ChrisColbourne/Hackathon26-/website/assets/photos/circuit-diagram.jpg

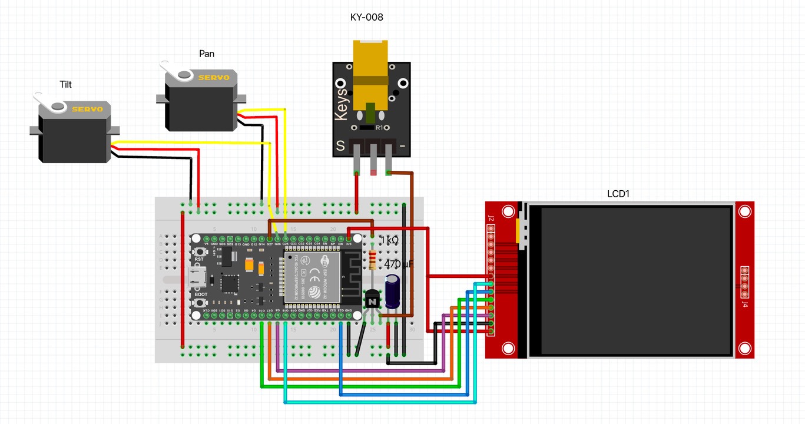
website/assets/photos/circuit-diagram.jpg
