ChrisColbourne/Hackathon26-/app/otter-website/incoming/robot_model.stl

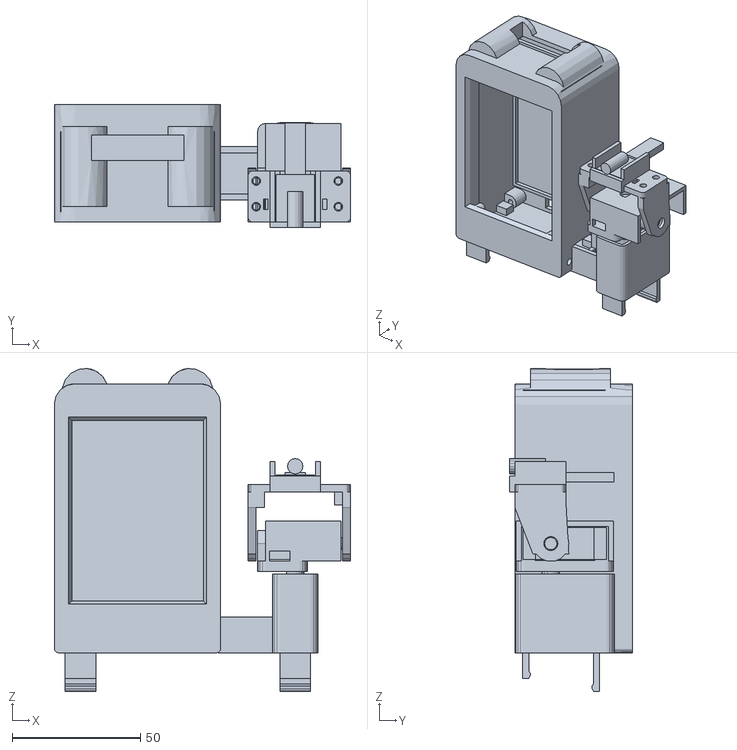
[picture p4: CAD file, 2026-10-04, last stored version]
app/otter-website/incoming/robot_model.stl
115.4 x 47.7 x 125.8
