ChrisColbourne/Hackathon26-/website/assets/photos/build-first-boot.jpg

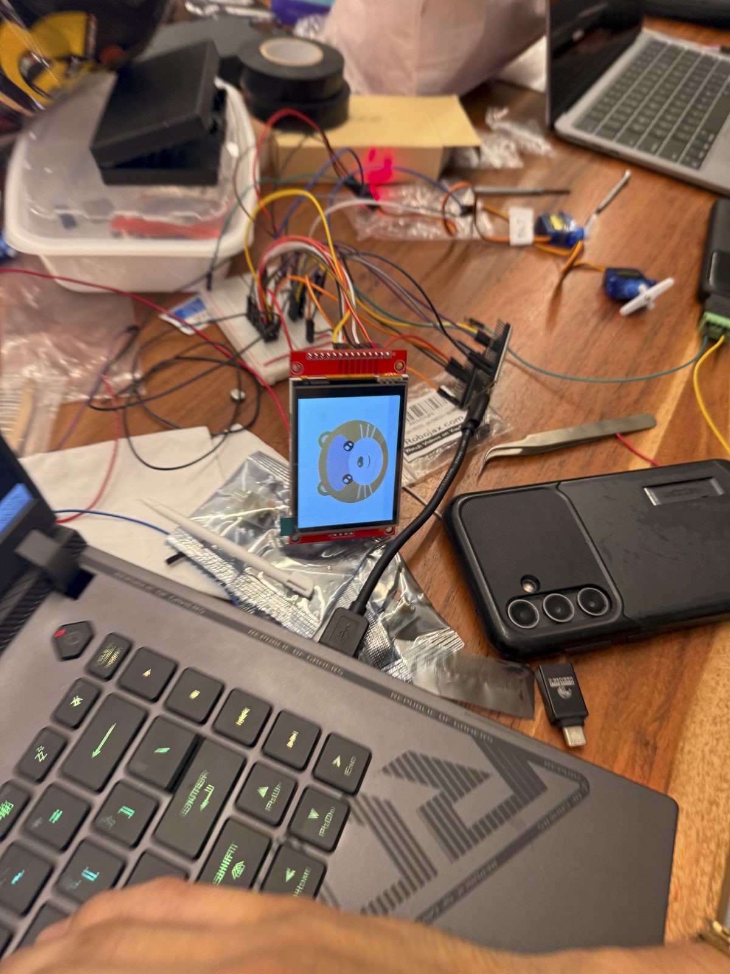
website/assets/photos/build-first-boot.jpg
