ChrisColbourne/Hackathon26-/website/assets/photos/build-printed-case.jpg

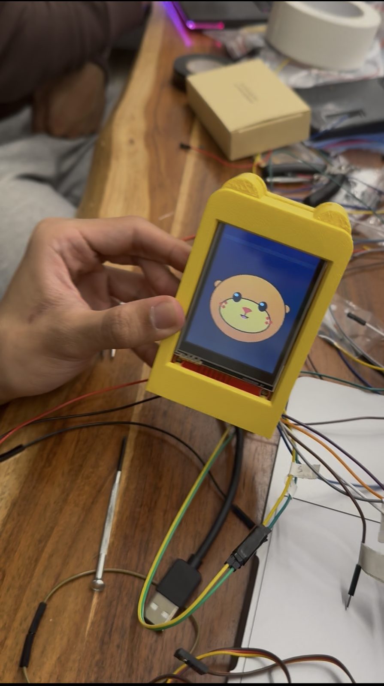
website/assets/photos/build-printed-case.jpg
