ChrisColbourne/Hackathon26-/website/assets/photos/final-back-wiring.jpg

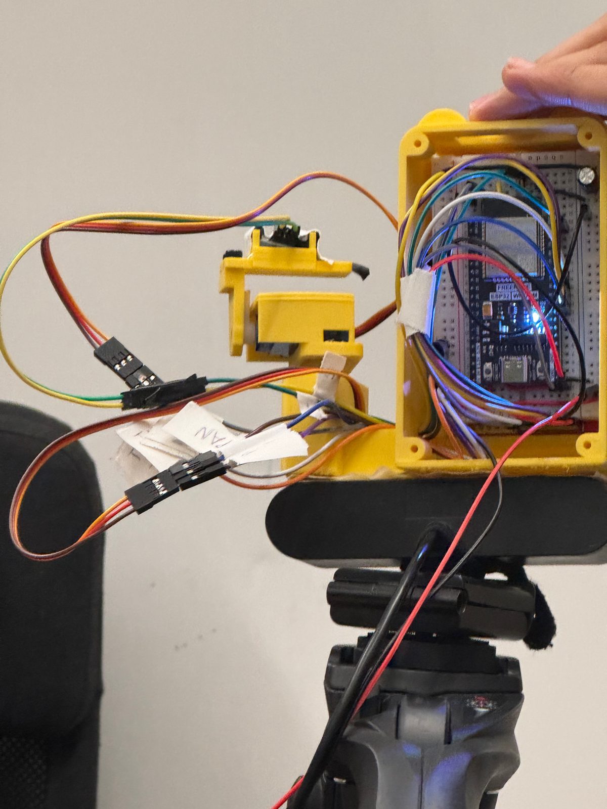
website/assets/photos/final-back-wiring.jpg
