ChrisColbourne/Hackathon26-/website/assets/photos/final-test-tripod.jpg

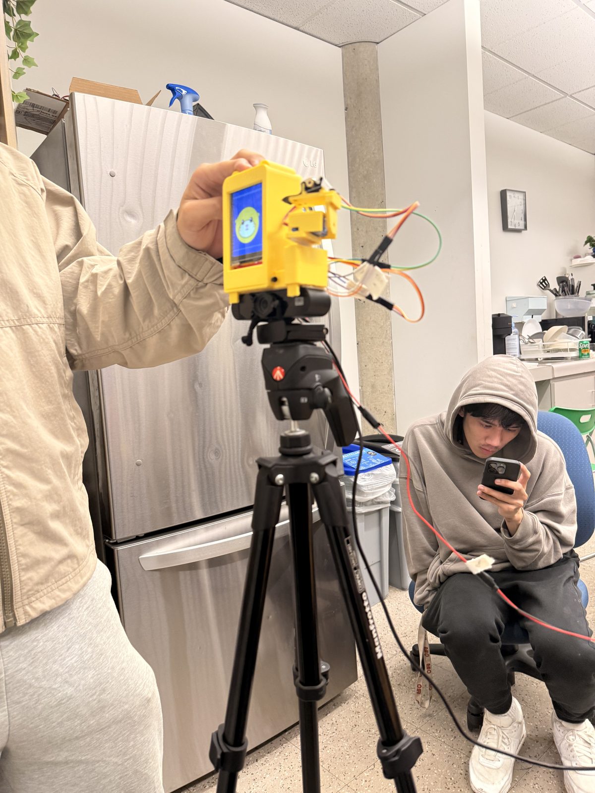
website/assets/photos/final-test-tripod.jpg
