ChrisColbourne/Hackathon26-/(commit log)

2026-10-04 Add the Gemini brain: webcam -> verdict -> nudge, robot and app server
    Laptop brain for the otter tutor (Person B). Reads the whiteboard through
    the USB webcam, decides whether each line is right, and has the otter
    flag mistakes out loud without ever giving away the fix.
    - gemini_brain: Interactions API with structured JSON (BoardAnalysis).
    Adaptive model chain (3.8 -> 3.7 -> 3.6-flash) that demotes models
    after 503s/timeouts/429s, API-key rotation, hard per-call deadline, and
    SDK retries disabled (they slept for the full 429 Retry-After).
    - verifier: SymPy re-derives derivatives/integrals/algebra and vetoes
    false flags on correct work.
    - policy: speak only above a confidence thresh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
2026-10-04 Add ESP32 otter firmware (PlatformIO + Arduino IDE versions)
    LeandroZambrano21's LCD/servo/laser firmware, uploaded via the GitHub web
    UI to both main and lcd_screen. Consolidated here on lcd_screen for review:
    - otter-robot-esp32/: PlatformIO project (as uploaded to lcd_screen)
    - otter-robot-arduino/: Arduino IDE sketch (as uploaded to main); its
    otter.cpp and net.cpp are edited versions of the PlatformIO ones
    Left out: both secrets.h files (they held real Wi-Fi credentials; copy
    secrets.example.h to secrets.h locally) and the *.bak originals.
    .gitignore now covers secrets.h, *.bak and .pio/.
2026-10-04 Brain: fix robot integration bugs found against the ESP32 firmware
    Tested with an emulator of the firmware's main.cpp state machine
    (pending / laserAfterMove, eased 50 Hz servo motion, laser timeout)
    driven by the real server in mock mode.
    - server: also accept the firmware's default path /robot (was 403).
    - server/robot: a reconnect after a Wi-Fi blip no longer gets detached
    when the server later notices the old socket closed. Before, the live
    robot was dropped and the brain silently fell back to mock commands.
    - robot: one ordered show(mood, box) sequence instead of running the
    mood head-tilt and the laser aim concurrently; a late look could
    re-target a pending laser. point_at sen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
2026-10-04 Firmware: connect to the brain on 8000, laser safety on look, one version
    Review fixes for the ESP32 firmware (PR #1), agreed with the team:
    - Keep the Arduino IDE version (newer: has the reconnect fix and the
    team's otter design); remove the stale PlatformIO copy, whose net.cpp
    reset the face, head and laser every 2 s while no server was running.
    - secrets.example.h: SERVER_PORT 8000 to match brain.server (path /robot
    is now accepted by the brain). test_server.py moves to 8000 as well, so
    the firmware needs no change between the brain and the test server.
    - otter_robot.ino: a plain look switches the laser off and cancels a
    pending laser-on. Before, a look arriving after a laser c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
2026-10-04 Brain: live preview, sensitive re-checks, USB bridge, robot test
    From the first full hardware session (camera + ESP32 + Gemini):
    - server --show: camera preview window with c (check now), b (board
    detection), q keys, so one command gives the view and drives the robot.
    Uvicorn runs on a background thread; Qt stays on the main thread.
    - Re-checking: change threshold 0.015 -> 0.0001 (CHANGE_THR). Measured
    on the real board: camera noise 0.00000, erasing one character
    0.00033; the old value missed every handwriting edit.
    - Policy: the flag-once key includes the wrong line's text, so writing
    a different wrong answer on the same line gets a new nudge.
    - Server logs one CHECK line per ch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
2026-10-04 Firmware: fix inverted laser, wireless (OTA) updates, flash.sh
    - LASER_ACTIVE_LOW: this robot's laser lights when GPIO 27 is LOW (wired
    without the transistor), so "off" kept it lit and idle meant always on.
    The pin is now also set before anything else at boot.
    - ArduinoOTA: flash over Wi-Fi with ./flash.sh ota (optional OTA_PASS in
    secrets.h); laser off and face "thinking" while an update runs.
    - flash.sh: build + flash over USB or Wi-Fi with arduino-cli.
    Verified on hardware with brain.tools.robot_test: face, laser off/on/off,
    pan left/right, tilt up/down all correct.
2026-10-04 Brain: auto-check every 5 s, always answer an on-demand check
    - MIN_CHECK_INTERVAL_S 12 -> 5 so edits are re-checked ~5 s apart
    (still waits for the board to hold still STILL_S first).
    - Pressing "c" now always gets a spoken reply. Auto checks stay quiet
    when there's nothing new; on demand the otter confirms correct work,
    repeats an earlier nudge (and re-aims the laser), or says why it
    can't judge yet (half-written line, unreadable, no problem on board).
2026-10-04 Firmware: portrait otter face for the vertically mounted LCD
    - Screen now 240x320 portrait (SCREEN_ROTATION 0 in config.h): the otter
    is drawn 90 deg counter-clockwise from the old landscape setup, so it
    stands upright once the LCD is turned clockwise into its mount. 2 flips
    it if it comes out upside down.
    - Face scaled to 90% (18 px clear each side) and moved into the lower part
    of the screen; thought bubble, "?", sound bars and stars moved above the
    head. Checked every mood renders fully on-screen.
2026-10-04 Brain: ElevenLabs voice, tap-to-talk, free chat, specific hints
    - Voice: ElevenLabs TTS streamed as raw PCM to the laptop speakers with
    real lip sync (mouth level from loudness, ~15/s) and an on-disk cache so
    repeated lines are free; "Jessica" premade voice by default.
    - Ears: tap `t` (or app `talk`), the laptop's built-in mic records until
    ~1 s of quiet, ElevenLabs Scribe transcribes. Webcam mics are never used.
    New brain/audio.py (parecord/pacat) and brain.tools.voice_test.
    - Free chat: Gemini's `reply` answers what the student said in the same
    board call; filtered so it never gives answers, formulas or rule names;
    confused face + laser when it's about the mistake.
    - Hints name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
2026-10-04 Fix false "looks right", quit segfault, calibration save crash
    - Verifier: plain-number lines are checked as written, so '1 + 1 = 3' is
    never vetoed as correct when Gemini reads the line as the problem.
    - Camera: release waits for an in-flight read (segfault on quit).
    - Calibration.save crashed (asdict applied twice); nothing could be saved.
2026-10-04 Add face test, laser calibration tool, and COMMANDS.txt cheat sheet
    - brain.tools.face_test: shows the six expressions on the real robot.
    - brain.tools.calibrate_laser: steer the laser onto the board's corners
    with the keyboard and save brain/calibration.json.
    - COMMANDS.txt: every command to run, test, flash, network and git.
2026-10-04 Robot power fixes: staggered servos, pan inverted, reconnect-safe tools
    - Firmware: servos start one at a time at power-up and aim pan-then-tilt,
    halving the current spike that browned out the ESP32 on a phone charger
    (restart loop; the laser never came on).
    - PAN_INVERT true: the replacement pan servo turns the other way.
    - calibrate_laser / face_test survive a robot restart: new RobotLink keeps
    the live connection, re-aims the laser after a reconnect, and says when
    the robot restarted (power) instead of crashing.
    - COMMANDS.txt: "Robot keeps restarting" quick fix.
2026-10-04 Firmware: tilt inverted, head can look lower (-40 deg)
    - TILT_INVERT true: + was tilting down (w/s were swapped in calibration,
    and the brain's aim was mirrored vertically).
    - TILT_MIN -25 -> -40 so the laser reaches the bottom of the whiteboard;
    the +15 up limit (laser below eye level) is unchanged. calibrate_laser
    uses the same limits.
2026-10-04 Brain: `p` pauses automatic checks (no Gemini calls while paused)
    - Preview key `p` (and app pause/resume) stops automatic checks and stuck
    prompts; `c` and `t` still work. Red banner in the preview, auto_paused
    in /health.
    - The settle detector keeps tracking while paused but doesn't fire, so on
    resume the board is checked once only if it changed since the last check.
2026-10-04 Add website
    [robot_model.stl]
2026-10-04 Website: publish only the site, from website/, on Netlify (ottertutor.tech)
    - Move the site to a top-level website/ folder (3 MB) and drop the rest of
    app/otter-website (repo copies, old backup, raw photos/video/STL, the
    author's notes); the working folder stays local as websiteCode/ (ignored).
    With app/ gone the brain no longer serves it: the site runs separately.
    - netlify.toml: publish website/, no build step, cache assets for a week.
    - Fix the tilt range on the page (now -40 to +15 deg); add a favicon.
    - COMMANDS.txt: how to preview the site and where it's published.
    [robot_model.stl]
2026-10-04 README: what Otter Tutor does, how it works, hardware, how to run it
    Rewritten for reviewers: the pitch with a photo of the robot and the CAD
    turntable, the hint ladder and never-give-the-fix rule, a pipeline diagram
    with what each stage does and where it lives, parts and pins, repo layout,
    setup and run steps, tools, and the team.
